Passionate0424/gemv_fsa_opensource/docs/spec/ipspec_page-1.png

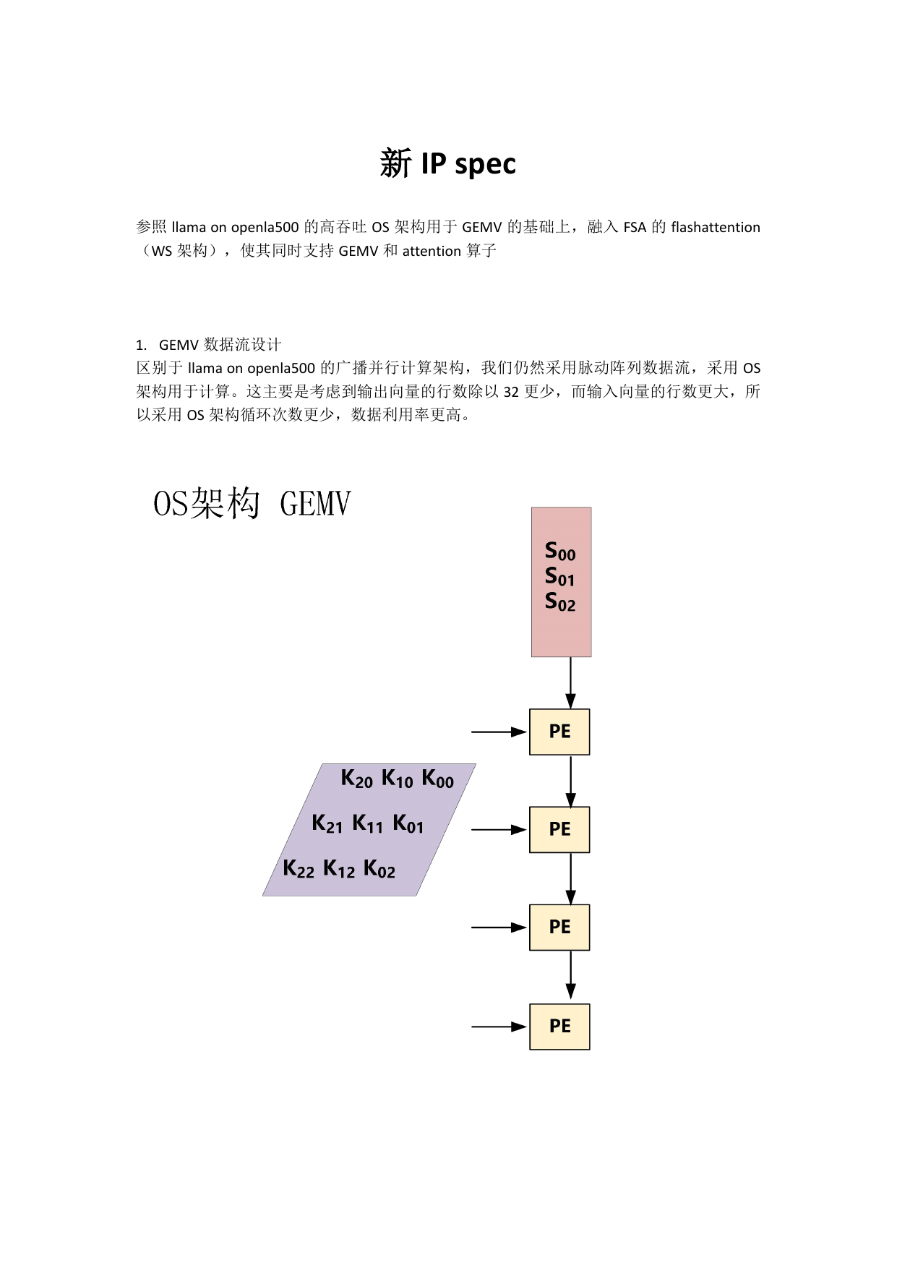
docs/spec/ipspec_page-1.png
