Passionate0424/gemv_fsa_opensource/docs/spec/ipspec_page-2.png

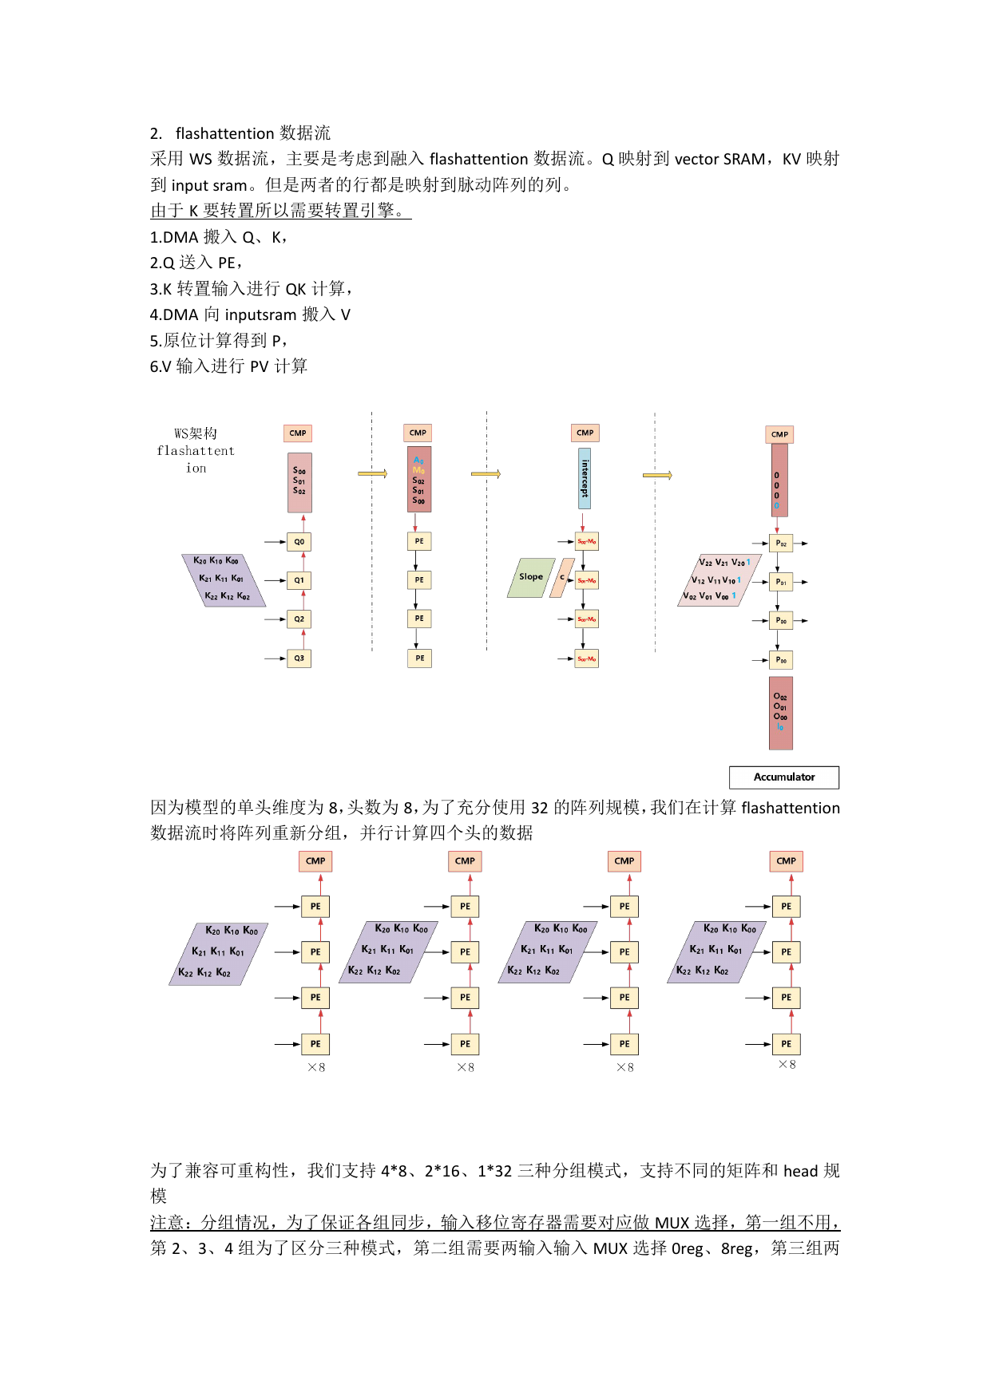
docs/spec/ipspec_page-2.png
