Passionate0424/gemv_fsa_opensource/docs/spec/ipspec_page-3.png

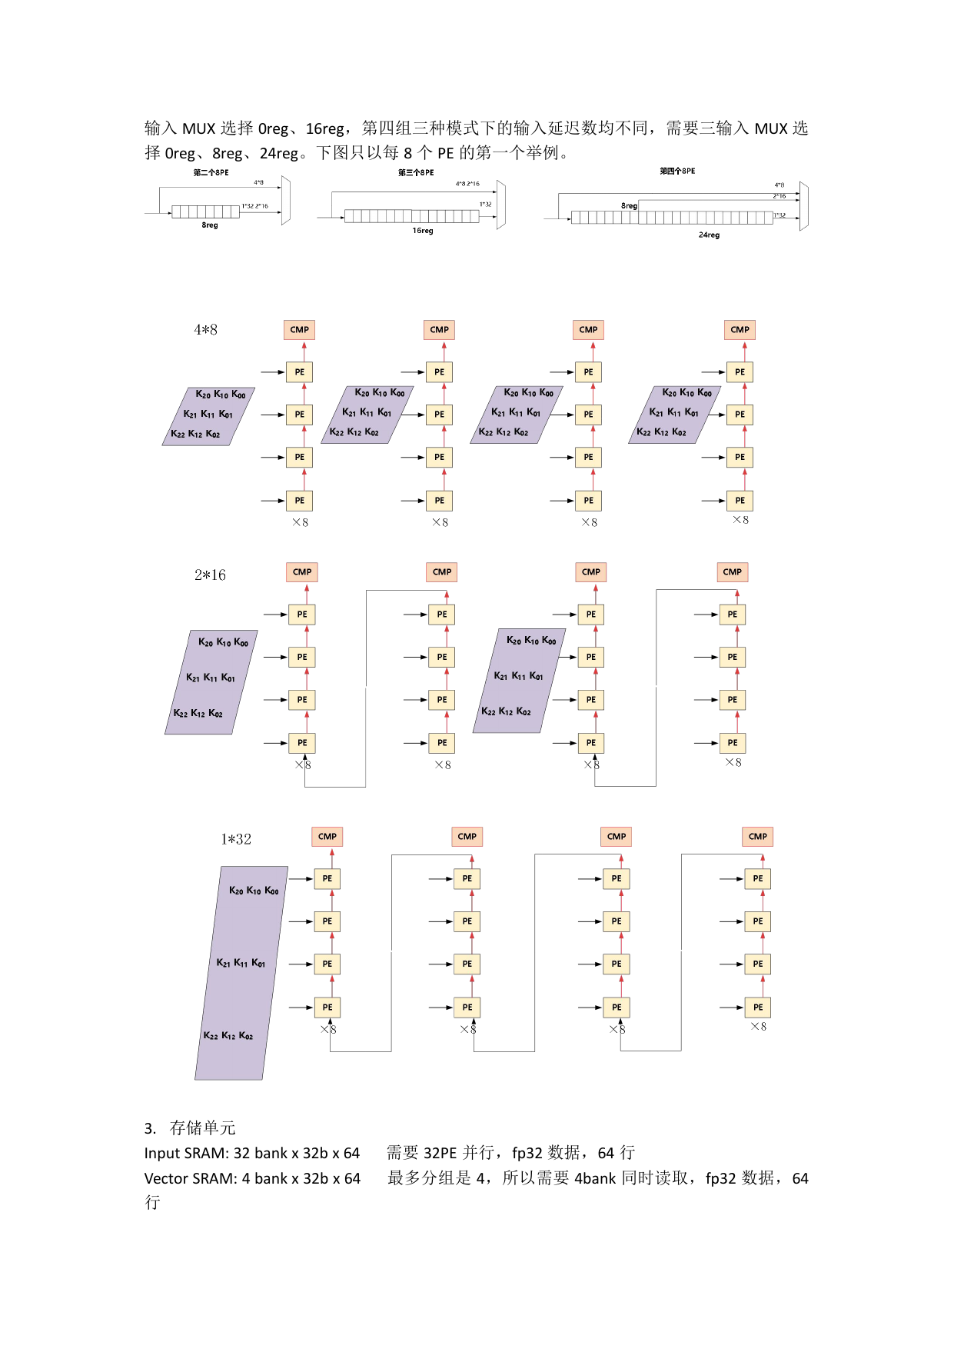
docs/spec/ipspec_page-3.png
