Passionate0424/gemv_fsa_opensource/docs/summary/accuracy_evaluation.md

# PWL exp2算子精度评估报告

## 1. 评估目标

评估FSA加速器中8段分段线性（PWL）近似exp2函数的精度，包括：
- exp2单算子精度（与论文对比）
- 端到端FlashAttention输出精度

## 2. 硬件实现

- **数据精度**：fp32（IEEE754单精度）
- **PWL分段数**：8段
- **分段方式**：SplitIF提取小数部分frac ∈ (-1, 0]，按|frac|的尾数高3位选段
- **计算方式**：exp2(x) = 2^int × (slope[seg] × frac + intercept[seg])
- **系数来源**：与论文原版Chisel实现一致（从RTL提取验证）

## 3. exp2单算子精度

### 3.1 评估方法

使用VCS仿真FPAccUnit_pipe模块的exp2模式，全量扫描32000个fp32负值输入（覆盖[-25, 0]区间），与fp64精确exp2(x)比对。

### 3.2 结果

| 指标 | 我们(fp32, 8段) | 论文(fp16, 8段) |
|---|---|---|
| MAE | 1.400×10⁻⁴ | 1.4×10⁻⁴ |
| MRE | 0.0626% | 2.728% |
| Max相对误差 | 0.094% | — |

### 3.3 按输入范围分布

| 输入范围 | 测试点数 | MAE | MRE | Max相对误差 |
|---|---|-----|-----|---|
| [-1, 0) | 8001 | 4.51×10⁻⁴ | 0.0626% | 0.094% |
| [-5, -1) | 8000 | 1.06×10⁻⁴ | 0.0626% | 0.094% |
| [-10, -5) | 4444 | 5.46×10⁻⁶ | 0.0626% | 0.094% |
| [-14, -10) | 3556 | 2.07×10⁻⁷ | 0.0626% | 0.094% |
| [-25, -14) | 7998 | 5.01×10⁻⁹ | 0.0626% | 0.094% |

### 3.4 分析

- **MAE完全一致**：验证PWL系数和分段逻辑与论文相同
- **MRE优44倍**：fp32 FMA 23位尾数精度优势（vs fp16 10位）
- **各区间MRE均匀**：SplitIF和指数缩放在fp32下无额外误差

## 4. 端到端FlashAttention精度

### 4.1 评估方法

使用VCS仿真tb_fsa_e2e（20个测试case），覆盖1~4 tile、不同seq_len和随机seed。golden为fp64标准softmax。排除近零值（|golden|<0.01）后统计MAE/MRE。

### 4.2 结果

| 指标 | 端到端FlashAttention |
|---|---|
| 测试case数 | 20 |
| 有效比对元素 | 590 |
| MAE | 1.17×10⁻³ |
| MRE | 0.0985% |
| Max相对误差 | 14.74% |
| Failed(rel>15%) | 0 |
| Warned(rel>5%) | 3 |
| PASS率 | 20/20 (100%) |

### 4.3 分析

- 端到端MRE=0.099%，仅比单exp2（0.063%）高0.04%——pipeline误差传播极小
- Max rel=14.74%来自极端score分布（接近15%阈值但未超），0个FAIL
- 3个WARN（5%~15%）出现在大值range(val_range=10)的随机case中
- 整个attention pipeline（QK→CMP→SUBTRACT→SCALE→EXP2→ROWSUM→PV→RESCALE→NORM）的精度损失可控

## 5. 软件模型验证

开发了Python精确模拟器（`scripts/eval/hw_fp_sim.py`），使用`np.float32`运算模拟硬件行为。经RTL仿真416点逐点对比，Python模型与硬件输出差异<1ULP，验证了模型的bit-accurate特性。可用于后续系数优化的快速评估。

## 6. 系数优化探索

### 6.1 优化方案

| 方案 | 改动 | exp2 MAE | exp2 MRE | 改善 |
|---|---|---|---|---|
| 原始(论文) | 基准 | 1.40×10⁻⁴ | 0.0626% | — |
| Chebyshev 8段 | 只换系数 | 6.40×10⁻⁵ | 0.0286% | 2.2x |
| 16段Accumulator | SplitIF扩4位+LUT扩16项 | 1.60×10⁻⁵ | 0.0071% | 8.8x |

### 6.2 端到端影响

| 方案 | E2E MAE | E2E MRE | E2E Max rel | PASS率 |
|---|---|---|---|---|
| 原始 | 1.17×10⁻³ | 0.099% | 14.74% | 20/20 |
| Chebyshev 8段 | 1.18×10⁻³ | 0.100% | 14.75% | 20/20 |
| 16段Accumulator | 1.16×10⁻³ | 0.098% | 14.74% | 20/20 |
| Chebyshev+16段 | 1.17×10⁻³ | 0.099% | 14.75% | 20/20 |

### 6.3 结论

- exp2单算子精度可通过换系数/增段数显著提升（2~9倍）
- **端到端精度不受exp2精度限制**——瓶颈在online softmax的rescale数值特性
- 最终采用Chebyshev 8段系数（单算子好2x，零硬件成本，端到端无退化）
- 16段方案stash保留，未来如需进一步优化可启用

### 6.4 系数生成方法

使用Chebyshev节点拟合（`scripts/eval/hw_fp_sim.py::generate_pwl_coefficients()`）：
- 对每段区间[-seg/8-1/8, -seg/8]，在两个Chebyshev节点处精确匹配exp2曲线
- 节点位置：t = mid ± half×cos(π/4)
- 通过两点的直线即为该段的近最优线性逼近（minimax意义）

### 6.5 段数收敛与 minimax 下界

脚本：`scripts/eval/exp2_convergence.py`（依赖 numpy + scipy，scipy 不在 py3.13 基础环境，用 conda base 运行：`D:/anaconda3/python.exe scripts/eval/exp2_convergence.py`）。

方法：
- **收敛评估**：相对误差只依赖小数部分 frac∈(-1,0]（`exp2(x)=2^int·2^frac`，逼近式同带 `2^int` 因子，相对误差与整数部分无关），故在一周期密采样即可评估任意分段数 N。
- **minimax 下界**：对每段解线性规划 `min_{s,c} max_t |s·t+c-2^t|/2^t`，即该段任意线性逼近能达到的最小"最大相对误差"，各段取最大即 N 段 PWL 的相对误差下界。

结果：

| N | Chebyshev MRE | Chebyshev max rel | 最小二乘 max rel | minimax 下界(LP) |
|---|---|---|---|---|
| 4 | 0.1145% | 0.1989% | 0.2681% | 0.1876% |
| 8 | 0.0286% | 0.0483% | 0.0647% | 0.0469% |
| 16 | 0.0071% | 0.0119% | 0.0159% | 0.0117% |
| 32 | 0.0018% | 0.0030% | 0.0039% | 0.0029% |

（原始论文 8 段系数作对照：max rel = 0.0939%，远高于下界。最小二乘拟合即
`generate_pwl_coefficients(N, method='lstsq')`，代表普通线性拟合基线，介于 Chebyshev 与
原始系数之间。报告图 3.11 用到 Chebyshev / 最小二乘 / minimax 三条线 + 原始 8 段单点。）

结论：
- 逼近误差随分段数按 **O(1/N²)** 收敛（N 每翻倍，误差降约 4×）。
- **Chebyshev 8 段 max rel 0.0483% 已贴近 minimax 下界 0.0469%（仅高约 3%）**——说明同段数下系数已近最优，继续优化系数收益极小。
- 原始论文系数 max rel 0.0939% 远高于下界，Chebyshev 拟合把它压到近极限。
- 结合 §6.2（端到端对系数不敏感），**8 段是精度/硬件的甜点**：再增段数单算子更准但端到端无收益、且硬件翻倍。

## 7. 总结

| 层级 | MAE | MRE | 说明 |
|---|-----|-----|---|
| exp2单算子(Chebyshev) | 6.40×10⁻⁵ | 0.029% | 比论文MAE好2x，MRE优95倍 |
| exp2单算子(原始) | 1.40×10⁻⁴ | 0.063% | 与论文MAE一致，MRE优44倍 |
| 端到端Attention | 1.17×10⁻³ | 0.099% | Pipeline传播损失极小 |

**总体评估：FSA加速器精度满足神经网络推理需求，端到端MRE<0.1%，所有测试case PASS。**

## 参考

[1] FSA: Systolic Array with FlashAttention, Section 6.2.1, Figure 13
