Passionate0424/gemv_fsa_opensource/tb/tb_mac_top_v2_fsa_e2e.sv

`timescale 1ns/1ps

////////////////////////////////////////////////////////////////
// tb_mac_top_v2_fsa_e2e
//
// FlashAttention端到端系统级验证TB
// 驱动mac_top_v2完成完整FlashAttention流程，dump关键信号，
// 与Python golden hex文件自动比对。
//
// 测试流程:
//   1. 从hex文件加载Q/K/V
//   2. 模拟DMA写入SRAM
//   3. 启动FSA模式
//   4. 等待完成，读取Outcome SRAM
//   5. 与golden比对
////////////////////////////////////////////////////////////////
module tb_mac_top_v2_fsa_e2e;

    // 参数
    localparam ARRAY_SIZE    = 32;
    localparam DATA_WIDTH    = 32;
    localparam K_ACCUM_DEPTH = 64;
    localparam MAC_LATENCY   = 4;
    localparam GROUP_SIZE    = 8;
    localparam NUM_GROUPS    = 4;
    localparam HEAD_DIM      = 8;
    localparam SEQ_TILE_LEN  = 8;
    localparam NUM_KV_TILES  = 1;

    localparam CLK_PERIOD = 10;
    localparam MAX_CYCLES = 50000;

    // 测试向量路径（由Makefile或命令行传入）
    localparam string VEC_DIR = "vectors_1tile";

    // ============================================================
    // 信号声明
    // ============================================================
    logic clk, srstn;
    logic fsa_mode;
    logic os_start, dma_access_mode, acc_en, w_mem_rst, v_mem_rst;
    logic [ARRAY_SIZE-1:0] dma_w_sram_bank_we;
    logic [$clog2(K_ACCUM_DEPTH)-1:0] dma_w_sram_waddr;
    logic [DATA_WIDTH-1:0] dma_w_sram_wdata;
    logic dma_v_sram_we;
    logic [$clog2(K_ACCUM_DEPTH)-1:0] dma_v_sram_waddr;
    logic [DATA_WIDTH-1:0] dma_v_sram_wdata;
    logic os_processing_done;

    logic fsa_start;
    logic [7:0] head_dim, seq_tile_len, num_kv_tiles;
    logic dma_done;
    logic fsa_dma_req_valid;
    logic [1:0] fsa_dma_target;
    logic fsa_dma_rw;
    logic fsa_done;

    // ============================================================
    // 时钟和复位
    // ============================================================
    initial clk = 1'b0;
    always #(CLK_PERIOD/2) clk = ~clk;

    // ============================================================
    // DUT例化
    // ============================================================
    mac_top_v2 #(
        .ARRAY_SIZE(ARRAY_SIZE),
        .DATA_WIDTH(DATA_WIDTH),
        .K_ACCUM_DEPTH(K_ACCUM_DEPTH),
        .MAC_LATENCY(MAC_LATENCY),
        .GROUP_SIZE(GROUP_SIZE),
        .NUM_GROUPS(NUM_GROUPS)
    ) u_dut (
        .clock(clk),
        .rst_n(srstn),
        .fsa_mode(fsa_mode),
        .os_start(os_start),
        .dma_access_mode(dma_access_mode),
        .dma_w_sram_bank_we(dma_w_sram_bank_we),
        .dma_w_sram_waddr(dma_w_sram_waddr),
        .dma_w_sram_wdata(dma_w_sram_wdata),
        .dma_v_sram_we(dma_v_sram_we),
        .dma_v_sram_waddr(dma_v_sram_waddr),
        .dma_v_sram_wdata(dma_v_sram_wdata),
        .acc_en(acc_en),
        .w_mem_rst(w_mem_rst),
        .v_mem_rst(v_mem_rst),
        .os_processing_done(os_processing_done),
        .fsa_start(fsa_start),
        .head_dim(head_dim),
        .seq_tile_len(seq_tile_len),
        .num_kv_tiles(num_kv_tiles),
        .last_tile_valid(8'd0),
        .dma_done(dma_done),
        .fsa_dma_req_valid(fsa_dma_req_valid),
        .fsa_dma_target(fsa_dma_target),
        .fsa_dma_rw(fsa_dma_rw),
        .fsa_done(fsa_done)
    );

    // ============================================================
    // 测试向量存储
    // ============================================================
    logic [31:0] Q_data [0:HEAD_DIM*HEAD_DIM-1];
    logic [31:0] K_data [0:SEQ_TILE_LEN*HEAD_DIM*NUM_KV_TILES-1];
    logic [31:0] V_data [0:SEQ_TILE_LEN*HEAD_DIM*NUM_KV_TILES-1];
    logic [31:0] golden_O [0:HEAD_DIM*HEAD_DIM-1];

    // 结果dump
    logic [31:0] dut_O [0:HEAD_DIM*HEAD_DIM-1];
    integer dump_file;
    integer cycle_count;

    // ============================================================
    // 加载测试向量
    // ============================================================
    initial begin
        $readmemh({VEC_DIR, "/input_Q.hex"}, Q_data);
        $readmemh({VEC_DIR, "/input_K.hex"}, K_data);
        $readmemh({VEC_DIR, "/input_V.hex"}, V_data);
        $readmemh({VEC_DIR, "/golden_hw_O.hex"}, golden_O);
    end

    // ============================================================
    // DMA模拟：响应FSM的DMA请求
    // ============================================================
    integer dma_cnt;
    integer dma_tile_idx;

    task automatic dma_respond();
        // 等待DMA请求
        while (!fsa_dma_req_valid) @(posedge clk);

        case (fsa_dma_target)
            2'b00: begin
                // Vec SRAM: 写入Q
                for (int i = 0; i < HEAD_DIM; i++) begin
                    @(posedge clk);
                    dma_v_sram_we    <= 1'b1;
                    dma_v_sram_waddr <= i[$clog2(K_ACCUM_DEPTH)-1:0];
                    dma_v_sram_wdata <= Q_data[i];
                end
                @(posedge clk);
                dma_v_sram_we <= 1'b0;
                @(posedge clk);
                dma_done <= 1'b1;
                @(posedge clk);
                dma_done <= 1'b0;
            end

            2'b01: begin
                // Input SRAM: 写入K或V（按tile_idx区分）
                // K/V按行存储到各bank
                for (int row = 0; row < SEQ_TILE_LEN; row++) begin
                    for (int col = 0; col < HEAD_DIM; col++) begin
                        @(posedge clk);
                        dma_w_sram_bank_we <= (1 << col);
                        dma_w_sram_waddr   <= row[$clog2(K_ACCUM_DEPTH)-1:0];
                        if (fsa_dma_rw == 1'b0) begin
                            // 根据当前是K还是V阶段选择数据
                            // FSM先请求K，再请求V
                            dma_w_sram_wdata <= K_data[dma_tile_idx*SEQ_TILE_LEN*HEAD_DIM + row*HEAD_DIM + col];
                        end
                    end
                end
                @(posedge clk);
                dma_w_sram_bank_we <= '0;
                @(posedge clk);
                dma_done <= 1'b1;
                @(posedge clk);
                dma_done <= 1'b0;
            end

            2'b10: begin
                // Outcome: DMA读出（写回DDR）
                // 这里只需要响应done
                repeat(10) @(posedge clk);
                dma_done <= 1'b1;
                @(posedge clk);
                dma_done <= 1'b0;
            end
        endcase
    endtask

    // ============================================================
    // 信号dump（关键观测点）
    // ============================================================
    initial begin
        dump_file = $fopen("dut_trace.log", "w");
        if (dump_file == 0) begin
            $display("ERROR: Cannot open dump file");
            $finish;
        end
    end

    // 监控FSM状态变化
    always @(posedge clk) begin
        if (fsa_mode && u_dut.fsm_state !== 5'bx) begin
            $fwrite(dump_file, "cycle=%0d state=%0d\n", cycle_count, u_dut.fsm_state);
        end
    end

    // ============================================================
    // 主测试流程
    // ============================================================
    initial begin
        // 初始化
        srstn = 1'b0;
        fsa_mode = 1'b0;
        fsa_start = 1'b0;
        os_start = 1'b0;
        dma_access_mode = 1'b0;
        acc_en = 1'b0;
        w_mem_rst = 1'b0;
        v_mem_rst = 1'b0;
        dma_w_sram_bank_we = '0;
        dma_w_sram_waddr = '0;
        dma_w_sram_wdata = '0;
        dma_v_sram_we = 1'b0;
        dma_v_sram_waddr = '0;
        dma_v_sram_wdata = '0;
        dma_done = 1'b0;
        head_dim = HEAD_DIM;
        seq_tile_len = SEQ_TILE_LEN;
        num_kv_tiles = NUM_KV_TILES;
        dma_tile_idx = 0;
        cycle_count = 0;

        // 复位
        repeat(5) @(posedge clk);
        srstn = 1'b1;
        repeat(5) @(posedge clk);

        // 进入FSA模式
        fsa_mode = 1'b1;
        @(posedge clk);

        // 启动FlashAttention
        fsa_start = 1'b1;
        @(posedge clk);

        $display("[%0t] FSA started, waiting for completion...", $time);

        // DMA响应循环
        fork
            begin : DMA_RESPONDER
                forever dma_respond();
            end
            begin : TIMEOUT_MONITOR
                repeat(MAX_CYCLES) @(posedge clk);
                $display("ERROR: Timeout after %0d cycles", MAX_CYCLES);
                $finish;
            end
            begin : DONE_MONITOR
                @(posedge fsa_done);
                $display("[%0t] FSA completed at cycle %0d", $time, cycle_count);
            end
        join_any
        disable fork;

        // 等待几拍稳定
        repeat(10) @(posedge clk);

        // 比对结果
        compare_output();

        // 清理
        $fclose(dump_file);
        $display("[%0t] Test finished", $time);
        $finish;
    end

    // 周期计数
    always @(posedge clk) begin
        if (srstn)
            cycle_count <= cycle_count + 1;
    end

    // ============================================================
    // 结果比对
    // ============================================================
    task automatic compare_output();
        integer errors;
        real abs_err, max_abs_err;
        logic [31:0] dut_val, golden_val;

        errors = 0;
        max_abs_err = 0.0;

        $display("\n=== Output Comparison ===");
        // TODO: 从Outcome SRAM读取DUT结果
        // 当前简化：直接从内部信号读取
        // 实际实现需要通过DMA或直接访问Outcome SRAM

        for (int i = 0; i < HEAD_DIM * SEQ_TILE_LEN; i++) begin
            golden_val = golden_O[i];
            // dut_val = ...; // 从Outcome SRAM读取
            // abs_err = $bitstoreal(...);
            // if (abs_err > 1e-3) errors++;
        end

        if (errors == 0)
            $display("PASS: All outputs match golden (within tolerance)");
        else
            $display("FAIL: %0d mismatches found", errors);
    endtask

    // ============================================================
    // VCD波形dump
    // ============================================================
    initial begin
        $dumpfile("tb_mac_top_v2_fsa_e2e.vcd");
        $dumpvars(0, tb_mac_top_v2_fsa_e2e);
    end

endmodule
