Passionate0424/gemv_fsa_opensource/uvm/sequences/cb_top_base_seq.sv

// CB_top_v2 基础虚拟Sequence
// 所有具体test sequence的基类，提供CSR读写和等待完成的公共方法
class cb_top_base_seq extends uvm_sequence;

  `uvm_object_utils(cb_top_base_seq)
  `uvm_declare_p_sequencer(cb_top_virtual_seqr)

  function new(string name = "cb_top_base_seq");
    super.new(name);
  endfunction

  // CSR写操作
  task csr_write(input logic [31:0] addr, input logic [31:0] data);
    axi_slv_seq_item item = axi_slv_seq_item::type_id::create("wr_item");
    item.constraint_mode(0);
    start_item(item, -1, p_sequencer.axi_slv_sqr);
    item.rw    = axi_slv_seq_item::AXI_WRITE;
    item.addr  = addr;
    item.wdata = data;
    finish_item(item);
  endtask

  // CSR读操作
  task csr_read(input logic [31:0] addr, output logic [31:0] data);
    axi_slv_seq_item item = axi_slv_seq_item::type_id::create("rd_item");
    item.constraint_mode(0);
    start_item(item, -1, p_sequencer.axi_slv_sqr);
    item.rw   = axi_slv_seq_item::AXI_READ;
    item.addr = addr;
    finish_item(item);
    data = item.rdata;
  endtask

  // 轮询STATUS寄存器等待done（每次CSR读本身消耗若干周期作为间隔）
  task wait_done(input int timeout_cycles = 200000);
    logic [31:0] status;
    int poll_count = timeout_cycles / 10;
    for (int i = 0; i < poll_count; i++) begin
      csr_read(32'h0004, status);
      if (status[1]) return;
    end
    `uvm_error("TIMEOUT", $sformatf("等待done超时: %0d polls", poll_count))
  endtask

  // DDR写入单字（通过mem_model backdoor）
  function void ddr_write(input int unsigned byte_addr, input logic [31:0] data);
    p_sequencer.mem.write_word(byte_addr, data);
  endfunction

  // DDR读取单字
  function logic [31:0] ddr_read(input int unsigned byte_addr);
    return p_sequencer.mem.read_word(byte_addr);
  endfunction

  // 硬件复位（与现有directed TB行为一致：rst_n拉低5拍→拉高→等5拍稳定）
  task hw_reset();
    uvm_hdl_deposit("tb_top.rst_n", 0);
    #100;  // 5 clk cycles @ 20ns
    uvm_hdl_deposit("tb_top.rst_n", 1);
    #100;  // 等待稳定
  endtask

  // PRNG（LCG，与现有TB一致）— 公共方法，子类复用
  function automatic logic [31:0] rand_fp32(ref int unsigned state, input real range);
    real val;
    state = state * 32'd1664525 + 32'd1013904223;
    val = ($itor($signed(state)) / 2147483648.0) * range;
    return $shortrealtobits(shortreal'(val));
  endfunction

  // ============================================================
  // 硬件位精确FP32原语：照抄rtl/fpmul_seq_pipeline.sv和rtl/fpadd_seq.sv
  // 的比特操作（纯截断，无round-to-nearest），不是IEEE标准舍入的
  // shortreal运算。GEMV的OS模式累加器用"超前计算"(look-ahead)实现，
  // 求和顺序与朴素顺序累加不同，FP32不满足结合律，只有严格复现硬件的
  // 截断算术+超前递归顺序，golden才能与DUT逐bit对齐（详见worklog）
  // ============================================================

  // 硬件FP32乘法器：对应fpmul_seq_pipeline.sv，尾数乘积取[45:23]截断
  function automatic logic [31:0] hw_fp_mul(logic [31:0] A, logic [31:0] B);
    logic a_sign, b_sign;
    logic [7:0] a_exp_raw, b_exp_raw;
    logic [22:0] a_frac, b_frac;
    logic is_nan, is_inf, is_zero, sign;
    logic [7:0] a_e, b_e;
    logic [23:0] a_m, b_m;
    logic [47:0] product;
    logic signed [9:0] exp_sum;
    logic prod_overflow;
    logic [47:0] shifted_product;
    logic signed [9:0] shifted_exp;
    logic need_norm;
    logic [47:0] final_product;
    logic signed [9:0] final_exp;

    a_sign = A[31]; b_sign = B[31];
    a_exp_raw = A[30:23]; b_exp_raw = B[30:23];
    a_frac = A[22:0]; b_frac = B[22:0];

    is_nan  = (a_exp_raw==8'hFF && a_frac!=0) || (b_exp_raw==8'hFF && b_frac!=0);
    is_inf  = (a_exp_raw==8'hFF) || (b_exp_raw==8'hFF);
    is_zero = (a_exp_raw==8'h0 && a_frac==0) || (b_exp_raw==8'h0 && b_frac==0);
    sign    = a_sign ^ b_sign;

    a_e = (a_exp_raw==8'h0) ? 8'd1 : a_exp_raw;
    b_e = (b_exp_raw==8'h0) ? 8'd1 : b_exp_raw;
    a_m = (a_exp_raw==8'h0) ? {1'b0,a_frac} : {1'b1,a_frac};
    b_m = (b_exp_raw==8'h0) ? {1'b0,b_frac} : {1'b1,b_frac};

    product = a_m * b_m;
    exp_sum = {2'b0,a_e} + {2'b0,b_e} - 10'sd127;

    if (is_nan)  return 32'h7FC00000;
    if (is_inf)  return {sign, 8'hFF, 23'd0};
    if (is_zero) return {sign, 31'd0};

    prod_overflow = product[47];
    if (prod_overflow) begin
      shifted_product = product >> 1;
      shifted_exp = exp_sum + 10'sd1;
    end else begin
      shifted_product = product;
      shifted_exp = exp_sum;
    end

    need_norm = (!prod_overflow) && (!product[46]) && (exp_sum > 0);
    if (need_norm) begin
      // multiplication_normaliser的LZD左移，与RTL的if-elif优先级一致
      if (product[46:41]==6'b000001) begin
        final_exp = exp_sum - 10'sd5; final_product = product << 5;
      end else if (product[46:42]==5'b00001) begin
        final_exp = exp_sum - 10'sd4; final_product = product << 4;
      end else if (product[46:43]==4'b0001) begin
        final_exp = exp_sum - 10'sd3; final_product = product << 3;
      end else if (product[46:44]==3'b001) begin
        final_exp = exp_sum - 10'sd2; final_product = product << 2;
      end else if (product[46:45]==2'b01) begin
        final_exp = exp_sum - 10'sd1; final_product = product << 1;
      end else begin
        final_exp = exp_sum; final_product = product;
      end
    end else begin
      final_product = shifted_product;
      final_exp = shifted_exp;
    end

    if (final_exp <= 0)   return {sign, 31'd0};
    if (final_exp >= 255) return {sign, 8'hFF, 23'd0};
    return {sign, final_exp[7:0], final_product[45:23]};
  endfunction

  // 硬件FP32加法器：对应fpadd_seq_2stage.sv的Stage1对阶/尾数加减
  // + addition_normaliser的LZD左移归一化（纯截断，无舍入）
  function automatic logic [31:0] hw_fp_add(logic [31:0] A, logic [31:0] B);
    logic a_sign, b_sign;
    logic [7:0] a_exp_raw, b_exp_raw;
    logic [22:0] a_frac, b_frac;
    logic a_is_nan, b_is_nan, a_is_zero, b_is_zero, a_is_inf, b_is_inf;
    logic [7:0] a_e, b_e;
    logic [23:0] a_m, b_m;
    logic o_sign;
    logic [7:0] o_exp;
    logic [24:0] o_man;
    logic [7:0] diff;
    logic [23:0] tmp_man;
    logic is_zero_r, overflow, normalized;
    logic [7:0] ne;
    logic [24:0] nm;

    a_sign = A[31]; b_sign = B[31];
    a_exp_raw = A[30:23]; b_exp_raw = B[30:23];
    a_frac = A[22:0]; b_frac = B[22:0];

    a_is_nan  = (a_exp_raw==8'hFF) && (a_frac!=0);
    b_is_nan  = (b_exp_raw==8'hFF) && (b_frac!=0);
    a_is_zero = (a_exp_raw==8'h0) && (a_frac==0);
    b_is_zero = (b_exp_raw==8'h0) && (b_frac==0);
    a_is_inf  = (a_exp_raw==8'hFF) && (a_frac==0);
    b_is_inf  = (b_exp_raw==8'hFF) && (b_frac==0);
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
