Passionate0424/gemv_fsa_opensource/(commit log)

2026-08-14 Initial commit: GEMV-FSA accelerator (RTL + TB + UVM + SoC integration)
    Frontend-only snapshot for open-source release, split out from a private
    repository with full development history. Includes the GEMV/FlashAttention-2
    accelerator RTL, directed testbenches, UVM verification environment, and the
    LoongSon-cup SoC integration used for the on-board LLaMA2 demo. Excludes all
    ASIC backend/PD content (TSMC 28nm PDK-derived data under foundry NDA),
    personal remote-EDA-server automation scripts, and internal working docs.
    [cov_hier.cfg]
2026-08-17 docs: 按技术报告与 RTL 实测订正 README
    原 README 多处数据陈旧或不实，逐条核对代码与集创赛技术报告后订正：
    - 目标模型：LLaMA2-7B → llama2.c/stories260K（5层 dim=64 8头 vocab=512）
    - 端到端加速比：15.9× → 加速器 27.6×、叠加 CPU FPU 后整体 210×
    （107,535,372 → 511,431 cycles/token，256-token 实测）
    - 覆盖率全部更新为 16-test 合并最新口径（Line 91.08%/Toggle 95.35% 等）
    - UVM 测试点 ~530 → ~590
    - exp2 精度按 RTL 内实际系数订正：反解 FPAccUnit_pipe.sv 的 8 段 LUT，
    实测最大相对误差 0.0483%，确认已是 Chebyshev 节点拟合而非论文原始系数
    - 补齐原先完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
2026-08-17 docs: README 补充参赛信息（集创赛龙芯中科杯总决赛，队伍编号 CICC1001054）
2026-08-17 docs: README 补充 SoC 总线加宽至 64 位一节
    原先 64 位总线只在性能表和目录树里作为列举项一笔带过，没有说明这是一项独立工作。
    补上瓶颈定位（卸载后 87.42% 的 GEMV 时间是纯搬运）、四项架构改动（互连替换为
    pulp axi_xbar、CPU 侧 dw_converter 升宽、外设直接加宽而非降宽、片上 SRAM 配合与
    返回通路 skid），以及代价收益（cycles/token −13.7%、GEMV.hw −41.1%、+3639 LUT）。
2026-08-17 docs: 订正项目背景中的两处技术表述错误
    1. 原文把「自回归解码阶段的 GEMV」与「attention 阶段的 FlashAttention-2」并列，
    属分类错误——自回归解码是推理阶段（相对 prefill），attention 是每层内部的环节，
    decode 阶段的每一层里两类算子都要算。改为按「解码阶段 → 层内两类算子」的层次重述。
    2. 原文称二者为「计算密集算子」，实际上 batch=1 的 decode 下两者都是访存密集
    （memory-bound）：GEMV 每个权重只用一次，attention 每步只有一行 Q 却要读完整
    KV cache。一并修正下游「瓶颈从算不过来变成搬不过来」的表述，改为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
2026-08-17 docs: 订正注意力一路的设计因果顺序
    原文写成「因为 softmax 夹在两个矩阵乘之间→所以选 WS→并融合 FlashAttention-2」，
    把 FlashAttention 降为数据流选型的附属产物，与实际设计顺序相反。
    实际是先在算法层选定 FlashAttention-2 的在线 softmax（沿序列维分块、逐块更新
    m/l 并对 O 做 rescale，不显式存储完整注意力矩阵，访存降为 O(N)），这一步与硬件
    无关；再由该算法的流式特性推导硬件数据流——OS 末端一次性 drain 无法在计算中途
    把中间结果送去比较，WS 天然支持「流出—变换—流回」，故注意力模式取 WS。
    改为分两步陈述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
2026-08-17 docs: 理顺项目背景的行文结构
    前一版把每类算子拆成「特征」和「数据流选型」两处分别陈述，导致线性层与注意力
    各出现两次、「权重矩阵远大于输入向量」原样重复，且 bullet 列表到加粗段落之间
    缺过渡。改为每类算子一段、从访存特征直接推到数据流选型，并在转入平台短板前
    补一句衔接。内容不变，只调结构与措辞。
2026-08-17 docs: README 引入 5 张架构图
    从技术报告仓库挑选与 README 现有论述直接对应、且不含过期数据的图：
    - top_architecture 顶层架构（CSR/DMA + 32-PE 阵列 + 四级 SRAM）
    - fsa_dataflow FSA 四阶段脉动数据流（QK^T→CMP→exp2 PWL→PV）
    - reconfig_grouping 4x8 / 2x16 / 1x32 三种可重构分组
    - gemv_os_dataflow GEMV 的 Output-Stationary 数据流
    - fpga_resource FPGA 布线后资源利用率（与正文表格数字一致）
    未引入的图及原因：perf_steps（标题仍是 16.4x、止步 6.56M，无 FPU/64位总线）、
    exp2_accuracy（MRE 0.0626%，换 Chebyshev 系数前的旧数据）、demo_screenshot
    （串口输出里 cycl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
2026-08-17 docs: 图片改用 markdown 语法，修复预览渲染
    原先用 <p align="center"><img src=...> 居中，VSCode markdown 预览默认拦截
    raw HTML 里的本地图片，导致图不显示；<sub> 标注里的 $QK^\top$ 等行内公式在
    HTML 块内也不会被解析。改为 ![](path) 图片语法 + 引用块图注，并把公式换成
    Unicode 字符（QKᵀ / M₀），在 GitHub 与本地预览下均可正常渲染。
2026-08-17 docs: README 精简为亮点导向，从 314 行收到 208 行
    README 在前几轮逐条纠错中膨胀成了压缩版技术报告。改为开门见山讲成果与优势，
    技术推导让位给 docs/ 与报告：
    - 新增「核心成果」节：210x / 精度逐 token 一致 / 590 测试点 / 可上板，四行看完
    - 原「项目背景」三大段数据流选型推导 + 「存储带宽扩展」整节（含五项改动细节）
    压缩为「设计要点」四条，每条 2-4 行配图
    - 「性能与精度」「验证状态」「综合成果」三节的表格并入核心成果，明细指向
    uvm/docs/verification_report.md
    - 快速开始里 28 个 UVM test 名清单改为指向验证报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
2026-08-22 docs: 修正 README 表格渲染并统一目录树注释对齐
    - 奖项行原为三列，在两列表格中会被渲染器丢弃「全国二等奖」，合并为单格
    - 空表头补为「项目 / 内容」，消除顶部空白表头带
    - 目录树注释统一对齐到第 34 列（原 rtl/ 块在 32 列、少数长路径行溢出）
    - 全文唯一一处 ASCII 直引号改为中文引号
2026-08-22 docs: 参考文献补 venue 与 arXiv 链接
    - FlashAttention-2 正式发表于 ICLR 2024，原仅标 arXiv 年份 2023
    - SystolicAttention 明确标注为 arXiv preprint（尚无正式 venue）
    - 三条统一补上 arXiv 链接，与全文其他条目的可点击风格一致
2026-08-22 docs: 参考文献改用官方引用格式
    - 作者名单按官方 BibTeX 补全（原用 et al. 简写）
    - 附官方 BibTeX 原文：FlashAttention 两篇取自 Dao-AILab/flash-attention
    的 Citation 段，SystolicAttention 取自 arXiv 导出条目
    - BibTeX 置于 <details> 折叠块，不影响正文浏览
